Barabaniuk/TimelapseDrone/WiringDiagram/TimelapseDrone.WiringDiagram_EN.pdf

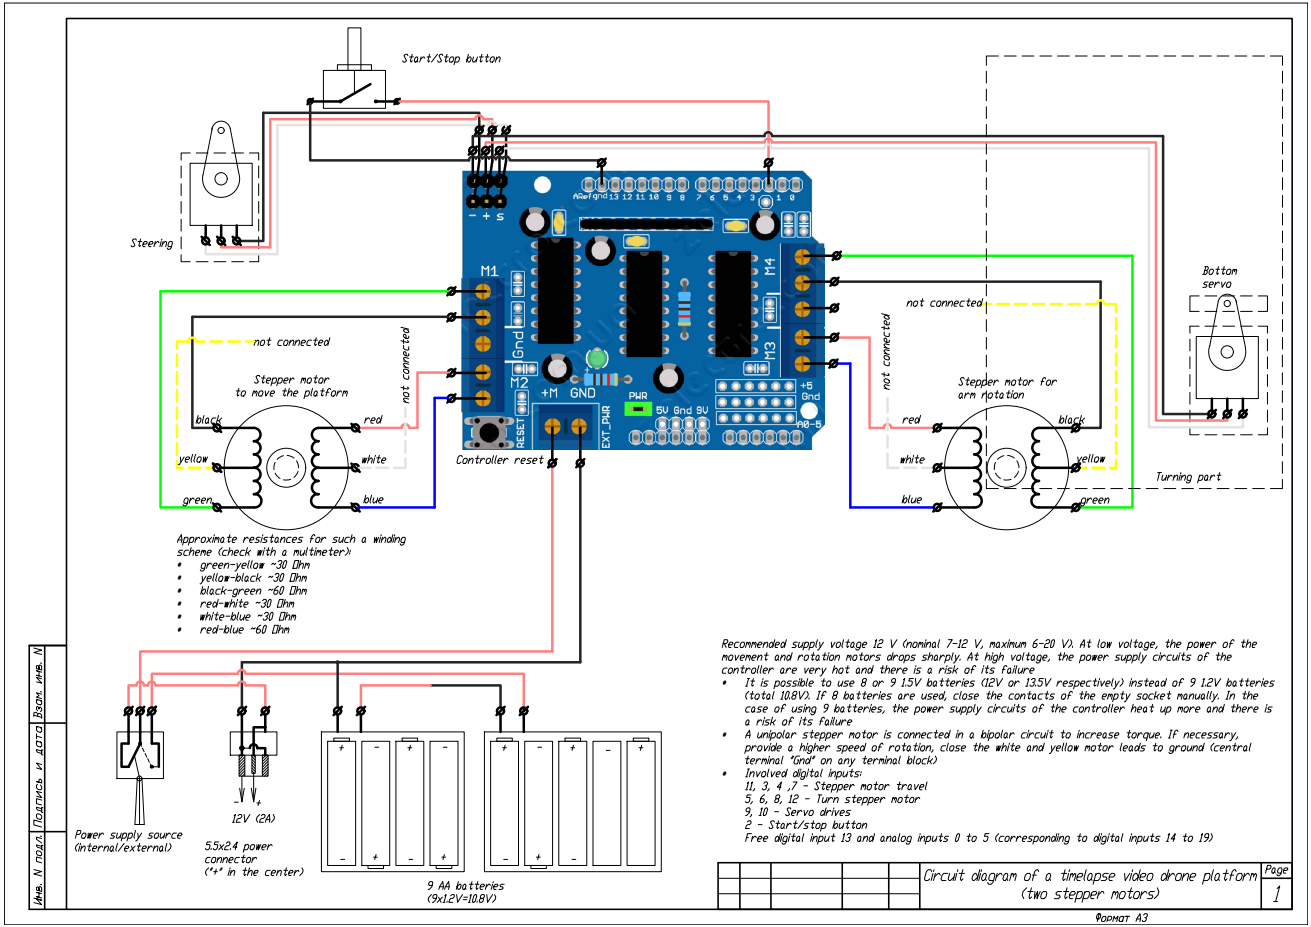
[picture p8: page 1]
