Barabaniuk/TimelapseDrone/WiringDiagram/TimelapseDrone.WiringDiagram_RU.pdf

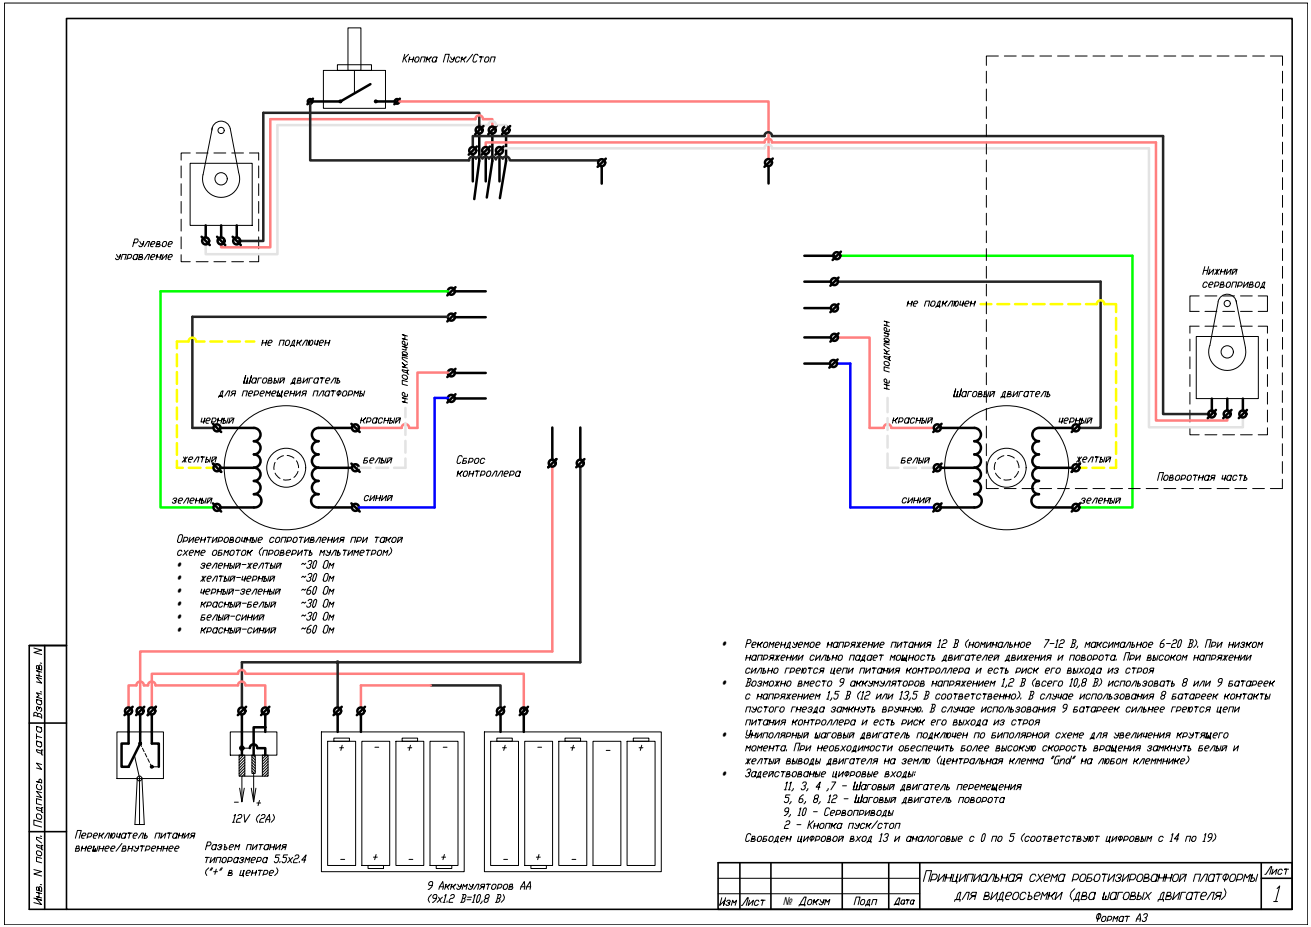
[picture p9: page 1]
