Barabaniuk/TimelapseDrone/WiringDiagram/TimelapseDrone.WiringDiagram_RU.jpg

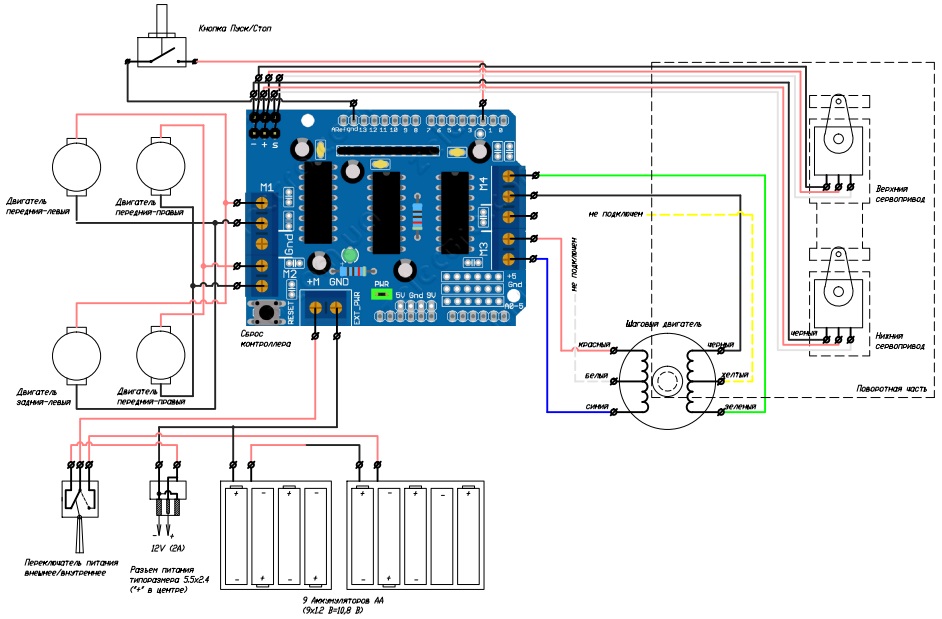
WiringDiagram/TimelapseDrone.WiringDiagram_RU.jpg
